pixiemars/GMSNPure/README.md

# GMSNPure
Schematics, BOMS and build guides for GMSN pure, incomplete, will add more as I get it.
