pixiemars/GMSNPure/GMSN_Pure_ADSR_Panel_20160820.dxf

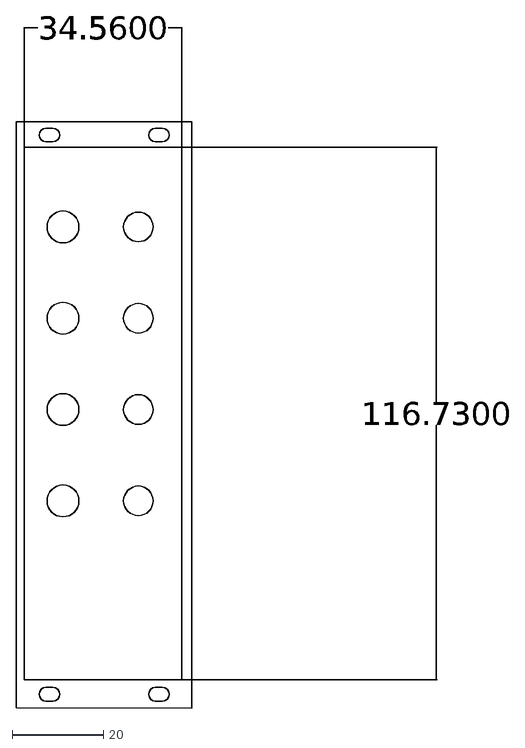
[picture p1: CAD file, 2018-12-03]
GMSN_Pure_ADSR_Panel_20160820.dxf
116.7300
34.5600
