pixiemars/GMSNPure/GMSN_Pure_VCO_v3.3.dxf

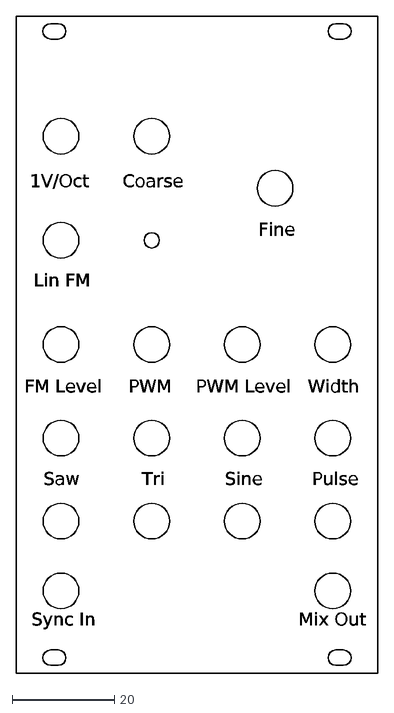
[picture p2: CAD file, 2018-12-03]
GMSN_Pure_VCO_v3.3.dxf
Mix Out
Saw
Tri
Sine
Pulse
Sync In
Width
PWM
PWM Level
1V/Oct
Coarse
Fine
Lin FM
FM Level
