pixiemars/GMSNPure/GMSN_Pure_VCF_Panel_20160820.dxf

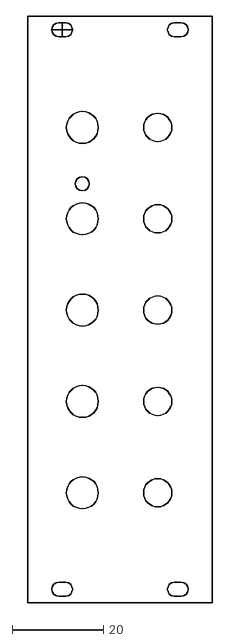
[picture p3: CAD file, 2018-12-03]
GMSN_Pure_VCF_Panel_20160820.dxf
40.3 x 128.5
