pixiemars/GMSNPure/GMSN_Pure_LFO_Panel_20160820.dxf

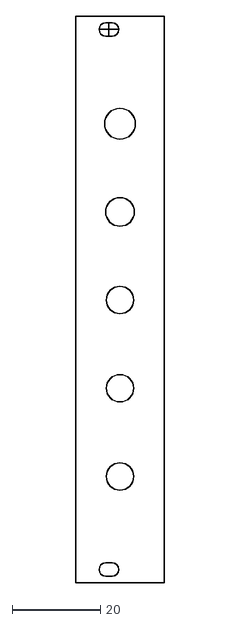
[picture p4: CAD file, 2018-12-03]
GMSN_Pure_LFO_Panel_20160820.dxf
20.0 x 128.5
