pixiemars/GMSNPure/GMSN_Pure_VCA_Panel_20160820.dxf

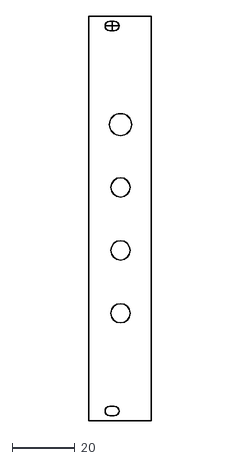
[picture p6: CAD file, 2018-12-03]
GMSN_Pure_VCA_Panel_20160820.dxf
20.0 x 128.5
