pixiemars/GMSNPure/Pure_ADSR_v2_Build_Doc_20180123.pdf

# GMSN!

# Pure ADSR v2 Build Doc

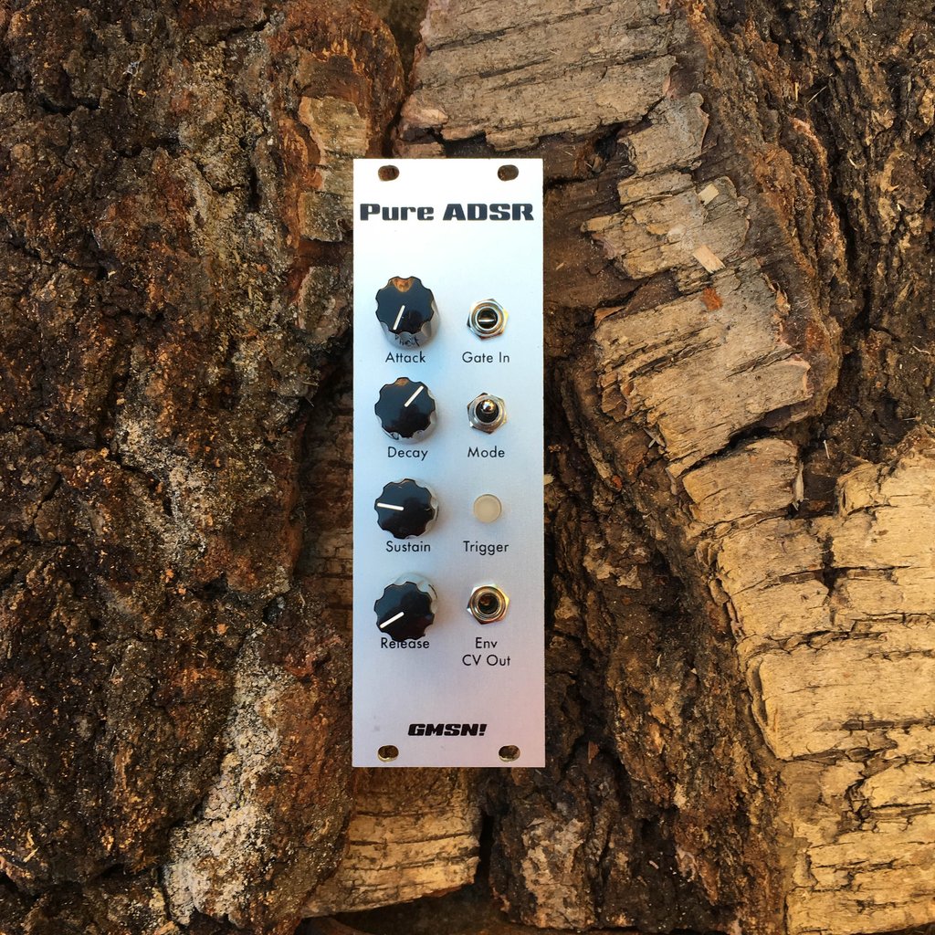
[picture p7: figure]

GMSN Pure ADSR Build Doc

Introduction

Building a Modular Synth is incredibly easy and rewarding. Not only do you get to build electronic devices from scratch, you also get an amazingly powerful electronic musical instrument when you’re finished.

GMSN! started off as a Saturday club at the Centre for Contemporary Arts in Glasgow as a place for people to come together and share their passion for Synth DIY. It very quickly grew with new members joining every weekend, learning how to solder and even going on to design their own modules. Despite all of this we have never lost sight of what GMSN! is all about… having fun building synths and providing a platform for the community to support new members.

We now have a full, open source, modular synth which people can build, available from gmsn.co.uk. These designs are backed up by a YouTube channel with loads of helpful videos and most importantly, the GMSN! Forum, where people from all around the world can get help and advice on their builds.

By following the steps outlined in this build doc you will be well on your way to building your own modular.

Let’s get started!

Quick Start

The high level steps to building the Pure ADSR are as follows

1) Follow the SMD Soldering Video and place all the SMD components as per the BoM.
2) Solder the 6 pin header and 10 pin shrouded header.
3) Place the jacks, pots and toggle switch, then fit the panel, before soldering them in place, ensuring they are all flush with the board.
4) Place the LED push button switch ensuring it is round the right way. There’s a little notch that matches the notch in the PCB. Fit the panel and solder in place.
5) Fit all the nuts for the jacks, pots and toggle switches, and the knobs on the pots
6) Flash code
7) Test and calibrate
8) Take loads of photos and post on social media how cool GMSN! is and how easy the modules are to make! :D

Step by step

1) Follow the SMD Soldering Video and place all the SMD components as per the BoM.
2) Solder the 6 pin header and 10 pin shrouded header.

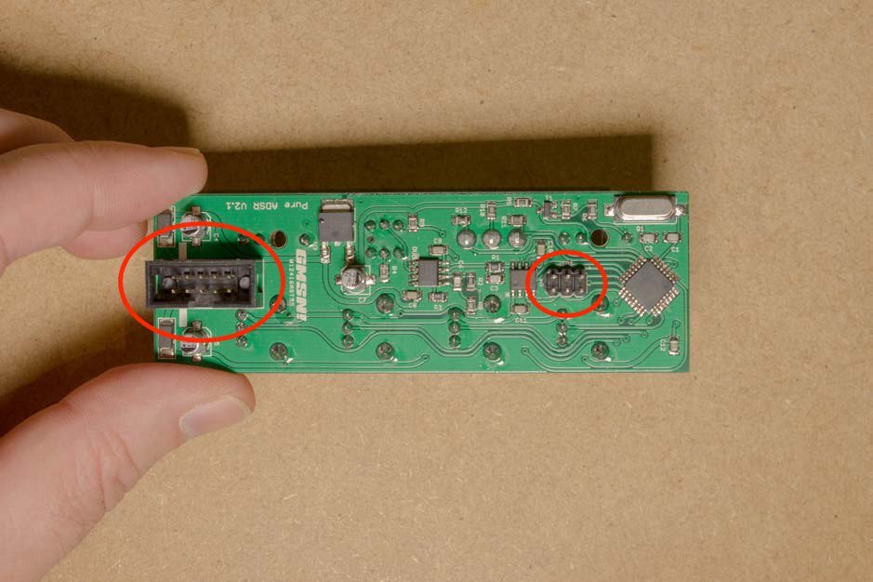
[picture p8: figure]
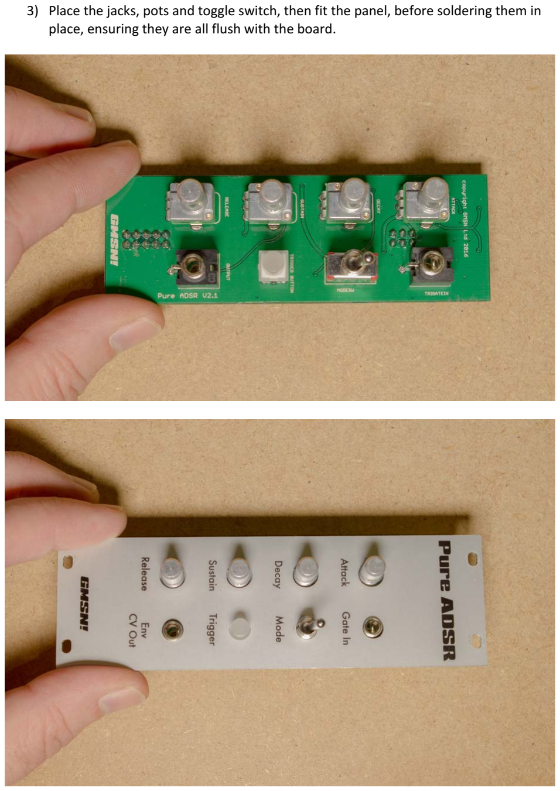
[picture p9: page 4]

3) Place the jacks, pots and toggle switch, then fit the panel, before soldering them in place, ensuring they are all flush with the board.

4) Place the LED push button switch ensuring it is round the right way. There’s a little notch that matches the notch in the PCB. Fit the panel and solder in place.

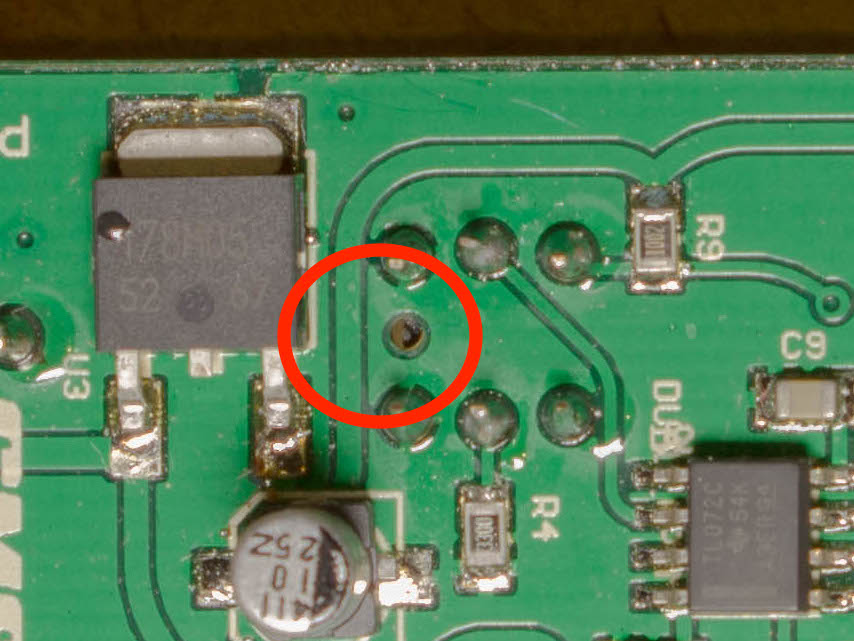
[picture p10: figure]

5) Fit all the nuts for the jacks, pots and toggle switches, and the knobs on the pots

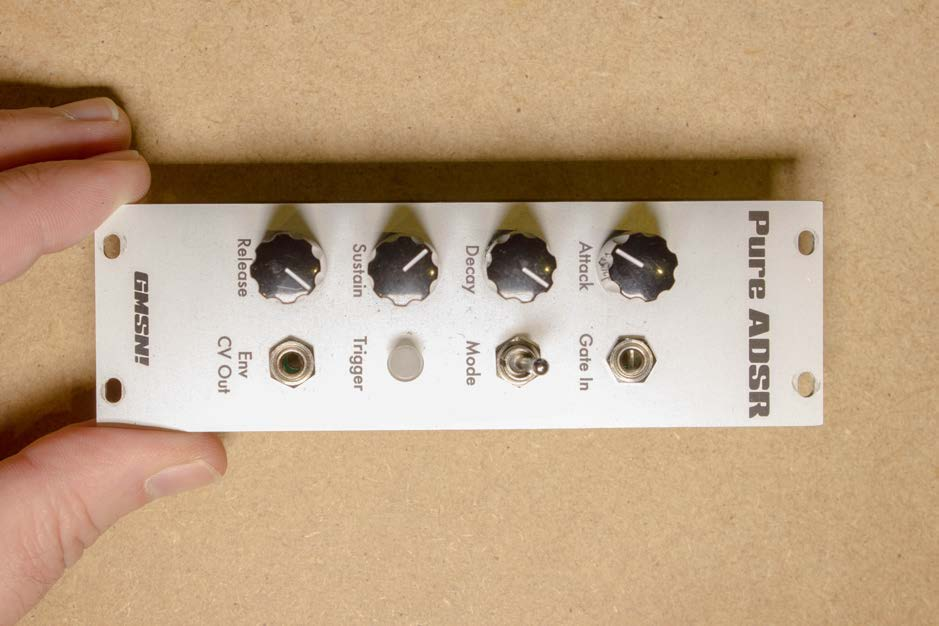
[picture p11: figure]

6) Flash code
7) Test and calibrate
8) Take loads of photos and post on social media how cool GMSN! is and how easy the modules are to make! :D

Further Support

If you have any question or I haven’t explained things very well in this build doc, please come and join the chat at the GMSN! Forum, chances are someone has already asked the question or if not someone will be able to answer.

If you have enjoyed build the Pure ADSR, check out the other modules that make up the Pure Modular and help to keep GMSN! Open Source.

Many thanks and kind regards

Rob
